flpvsk/read-repeat/design/feedback-tayda-v3-white-fix.pdf

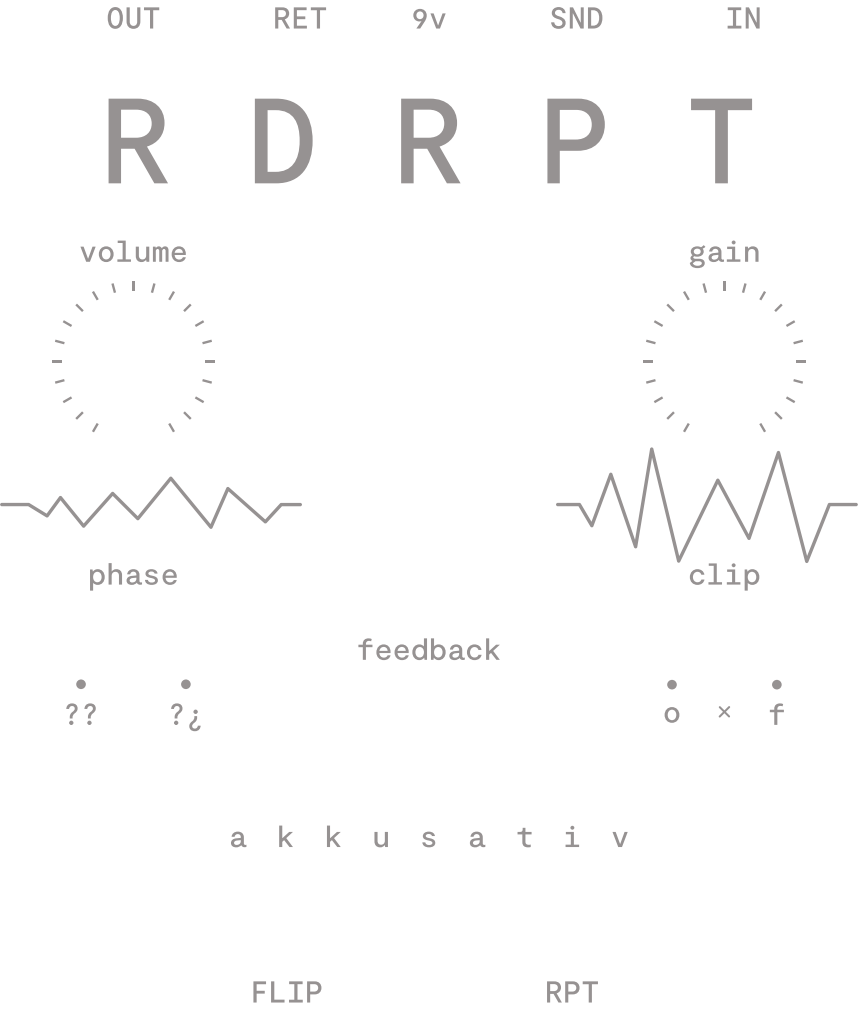
[picture p1: page 1]
