flpvsk/read-repeat/design/feedback-tayda.pdf

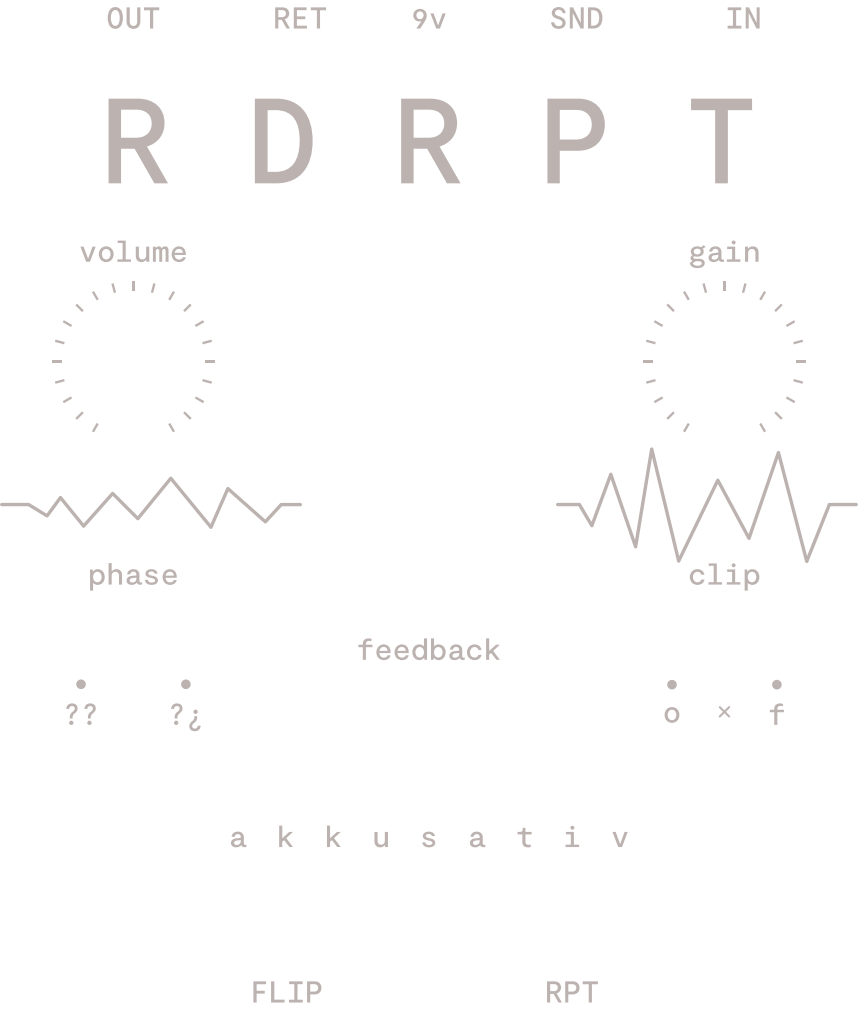
[picture p2: page 1]
