flpvsk/read-repeat/exports/RDRPT-main.pdf

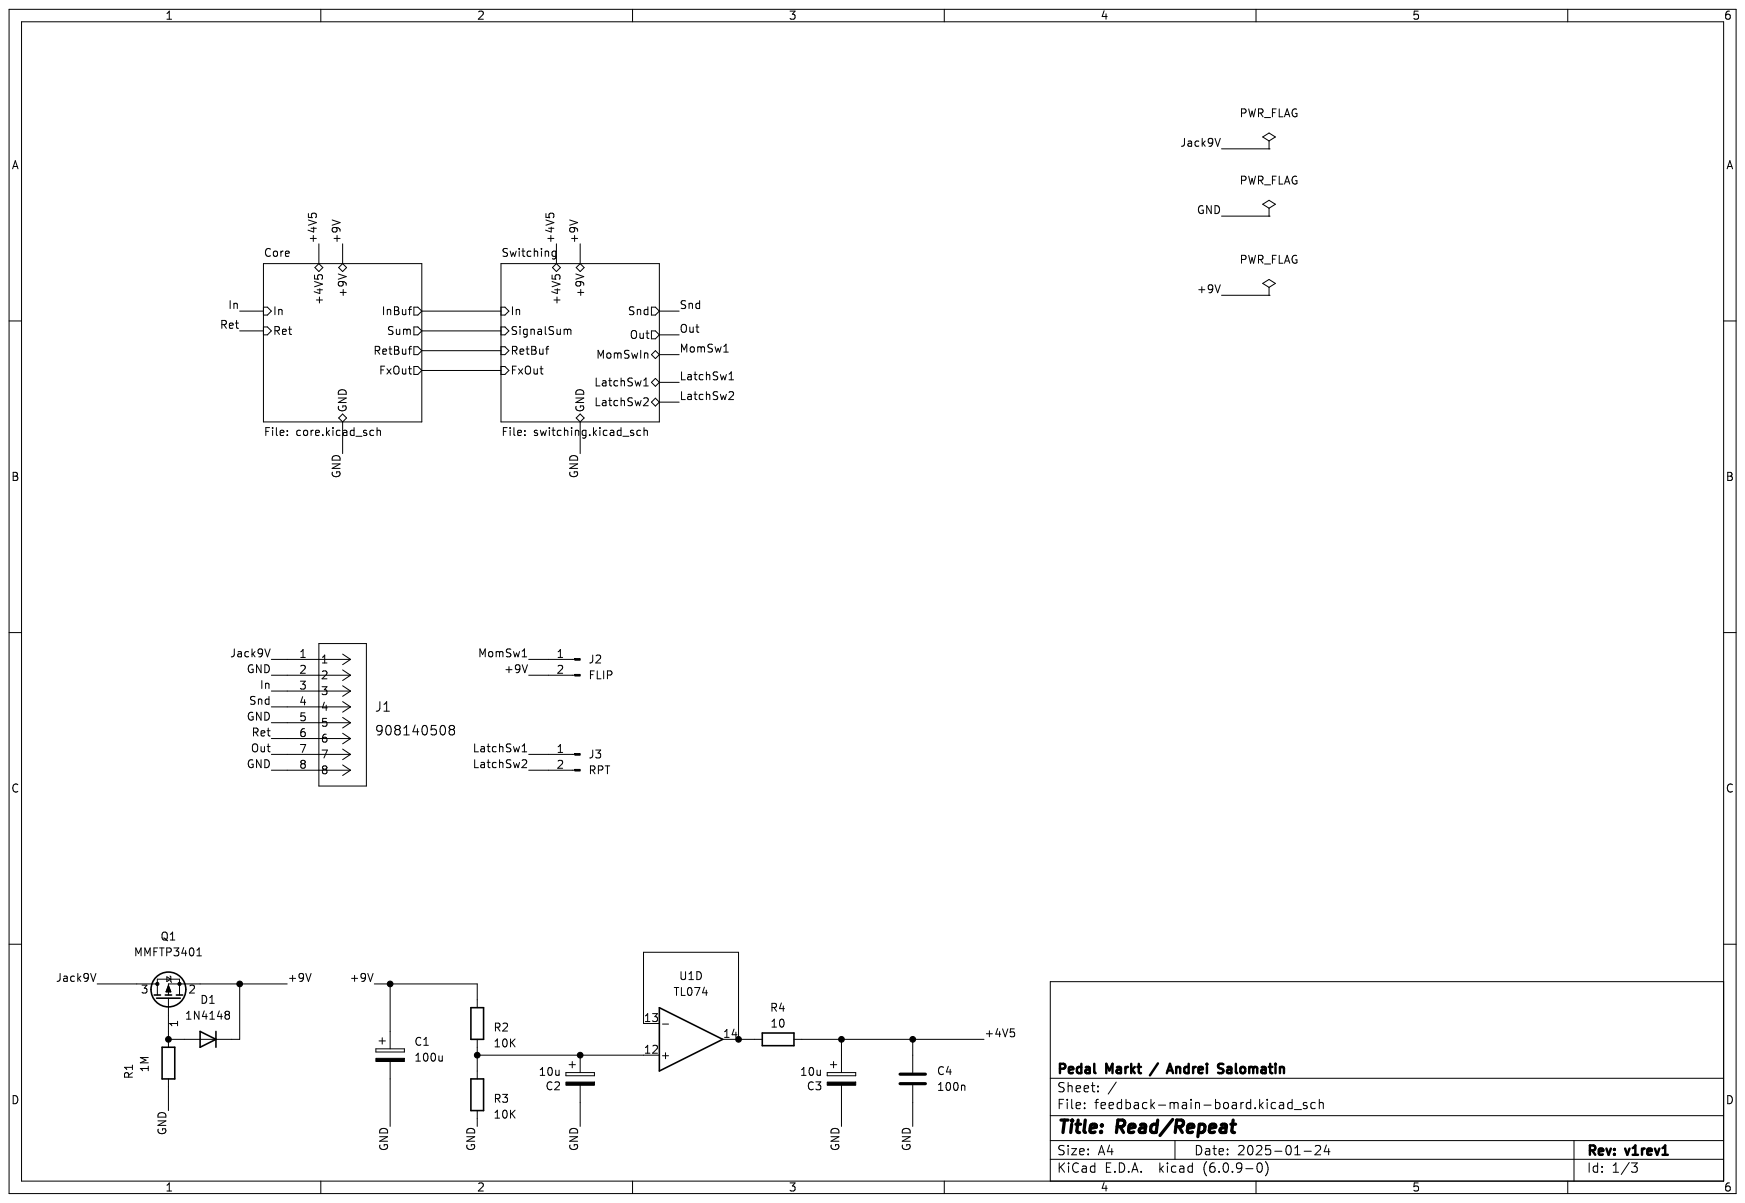
[picture p3: page 1]

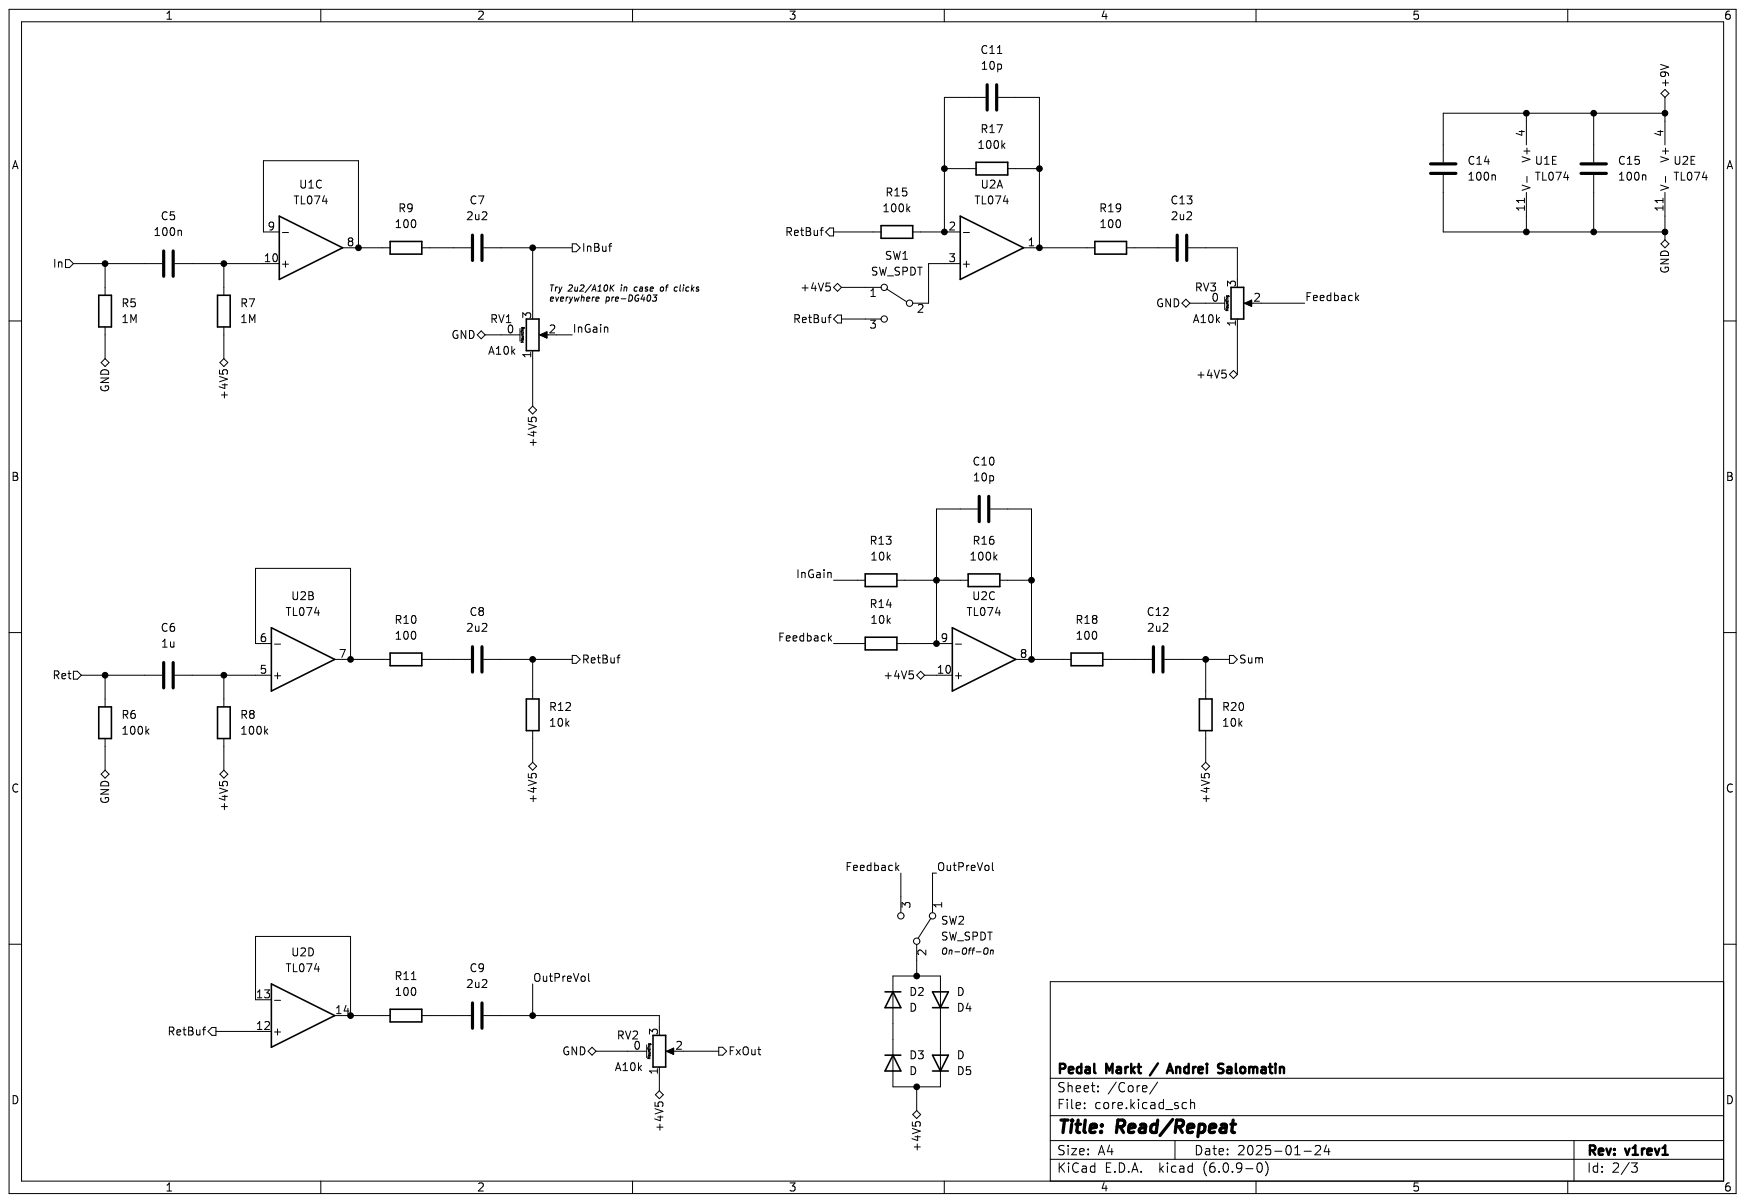
[picture p4: page 2]

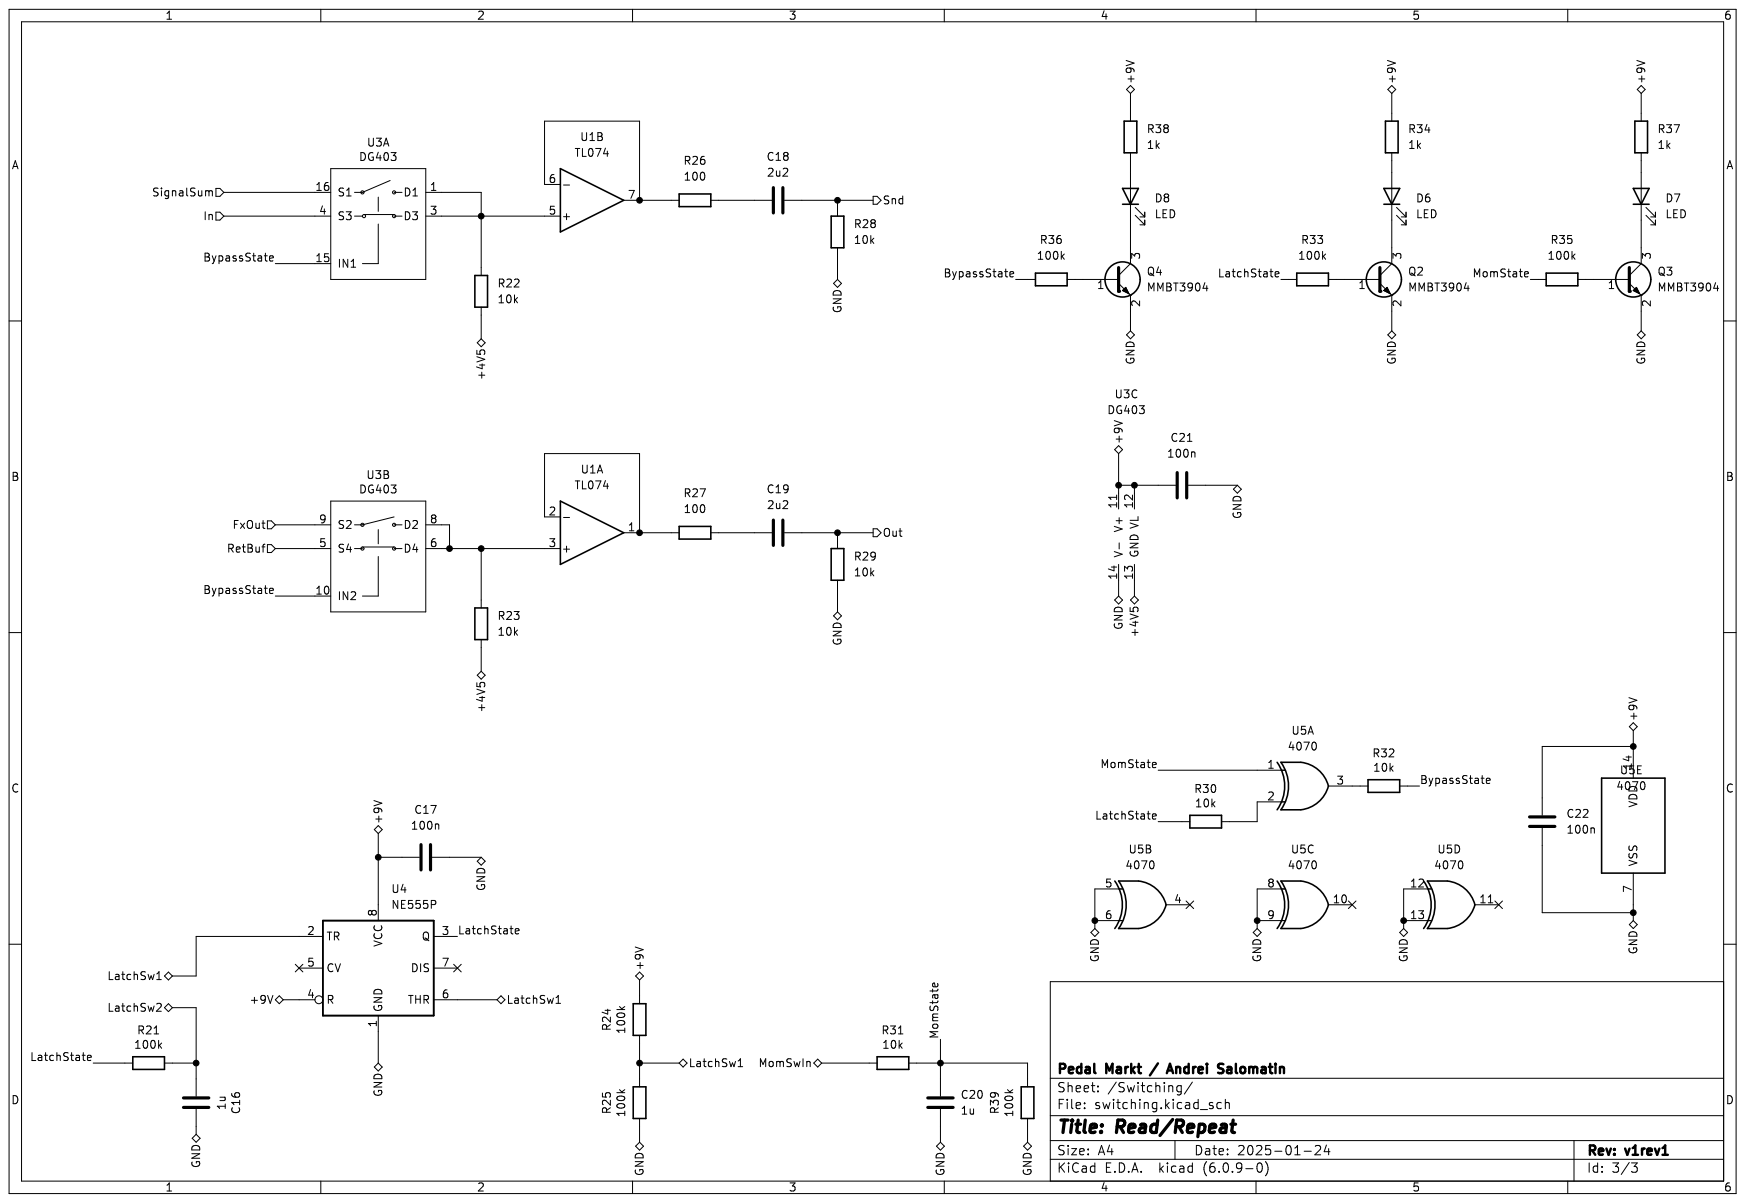
[picture p5: page 3]
