flpvsk/read-repeat/design/feedback-tayda-v2-white-fix.pdf

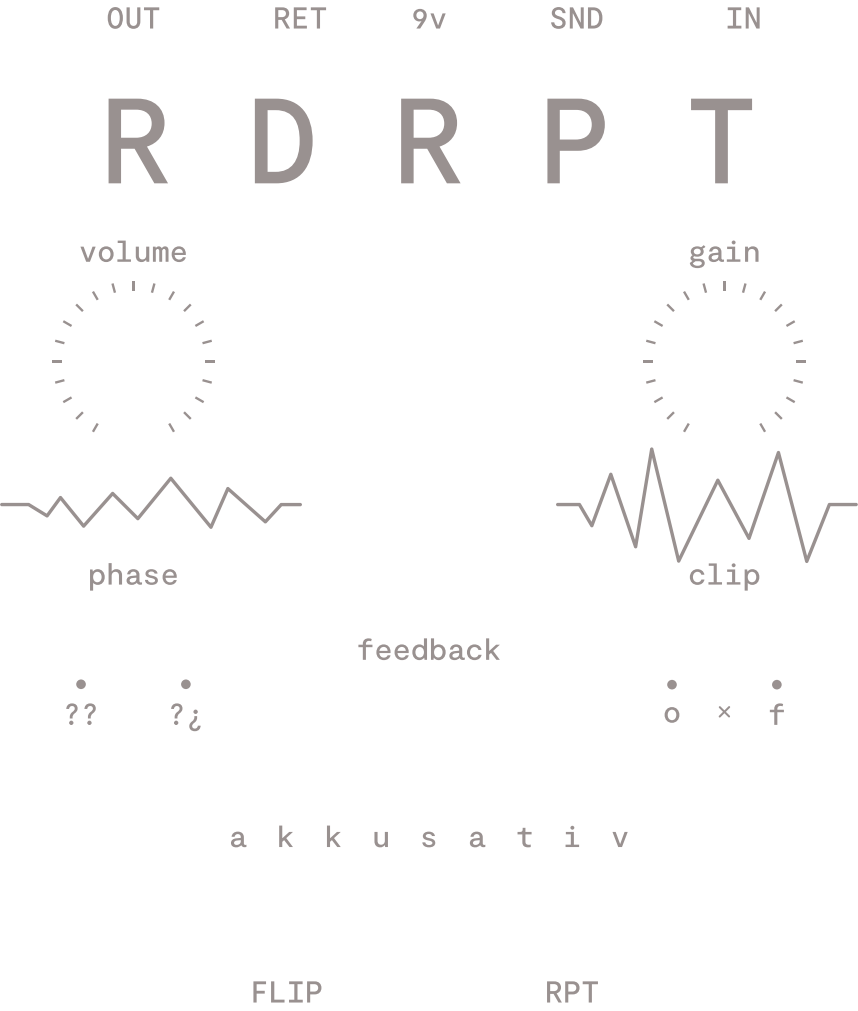
[picture p6: page 1]
