flpvsk/read-repeat/feedback-main-board/feedback-main-board.kicad_pcb

## KiCad design feedback-main-board/feedback-main-board.kicad_pcb (2025-05-19)

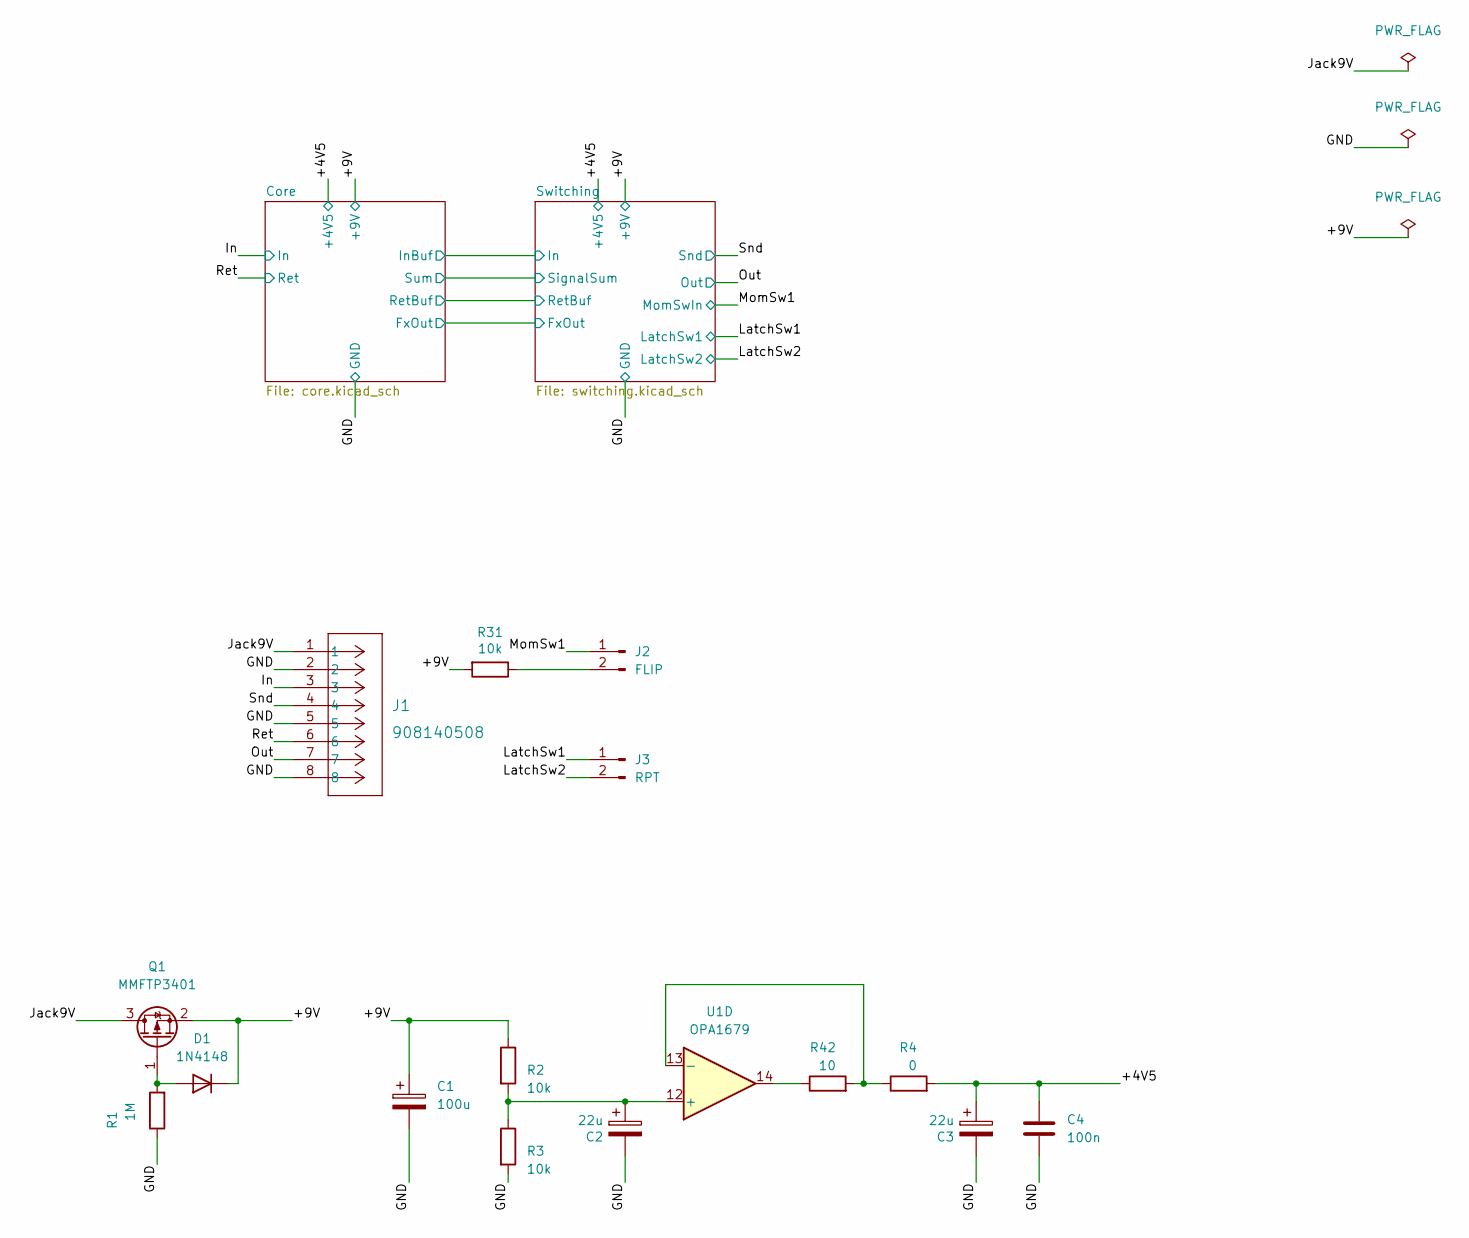
[picture p7: schematic feedback-main-board.kicad_sch, Read/Repeat]

Parts:
C1: 100u; CP_Elec_6.3x5.4; LCSC C2836437
C2, C3: 22u; CP_Elec_5x5.4; LCSC C23289
C4: 100n; C_0603_1608Metric_Pad1.08x0.95mm_HandSolder; Mouser 581-06035C105MAT2A
D1: 1N4148; D_SOD-323_HandSoldering; LCSC C6423741
J1: 908140508; CONN_SDA-90814_08_MOL; LCSC DNP
J2: FLIP; JST_XH_B2B-XH-A_1x02_P2.50mm_Vertical; LCSC DNP
J3: RPT; JST_XH_B2B-XH-A_1x02_P2.50mm_Vertical; LCSC DNP
Q1: MMFTP3401; SOT-23; LCSC C596234
R1: 1M; R_0603_1608Metric_Pad0.98x0.95mm_HandSolder; LCSC C22935
R2, R3, R31: 10k; R_0603_1608Metric_Pad0.98x0.95mm_HandSolder; LCSC C25804
R4: 0; R_0603_1608Metric_Pad0.98x0.95mm_HandSolder; LCSC C21189
R42: 10; R_0603_1608Metric_Pad0.98x0.95mm_HandSolder; LCSC C22859
U1: OPA1679; SOIC-14_3.9x8.7mm_P1.27mm; LCSC C2878631

Connections:
/+4V5: C3.1, C4.2, R4.2; also elsewhere on the board
/+9V: C1.1, D1.1 (K), Q1.2 (S), R2.1, R31.2; also elsewhere on the board
/GND: C1.2, C2.2, C3.2, C4.1, J1.2, J1.5, J1.8, R1.1, R3.2; also elsewhere on the board
/In: J1.3; also elsewhere on the board
/Jack9V: J1.1, Q1.3 (D)
/LatchSw1: J3.1; also elsewhere on the board
/LatchSw2: J3.2; also elsewhere on the board
/MomSw1: J2.1; also elsewhere on the board
/Out: J1.7; also elsewhere on the board
/Ret: J1.6; also elsewhere on the board
/Snd: J1.4; also elsewhere on the board
unnamed: C2.1, R2.2, R3.1, U1.12 (+)
unnamed: D1.2 (A), Q1.1 (G), R1.2
unnamed: J2.2, R31.1
unnamed: R4.1, R42.2, U1.13 (-)
unnamed: R42.1, U1.14

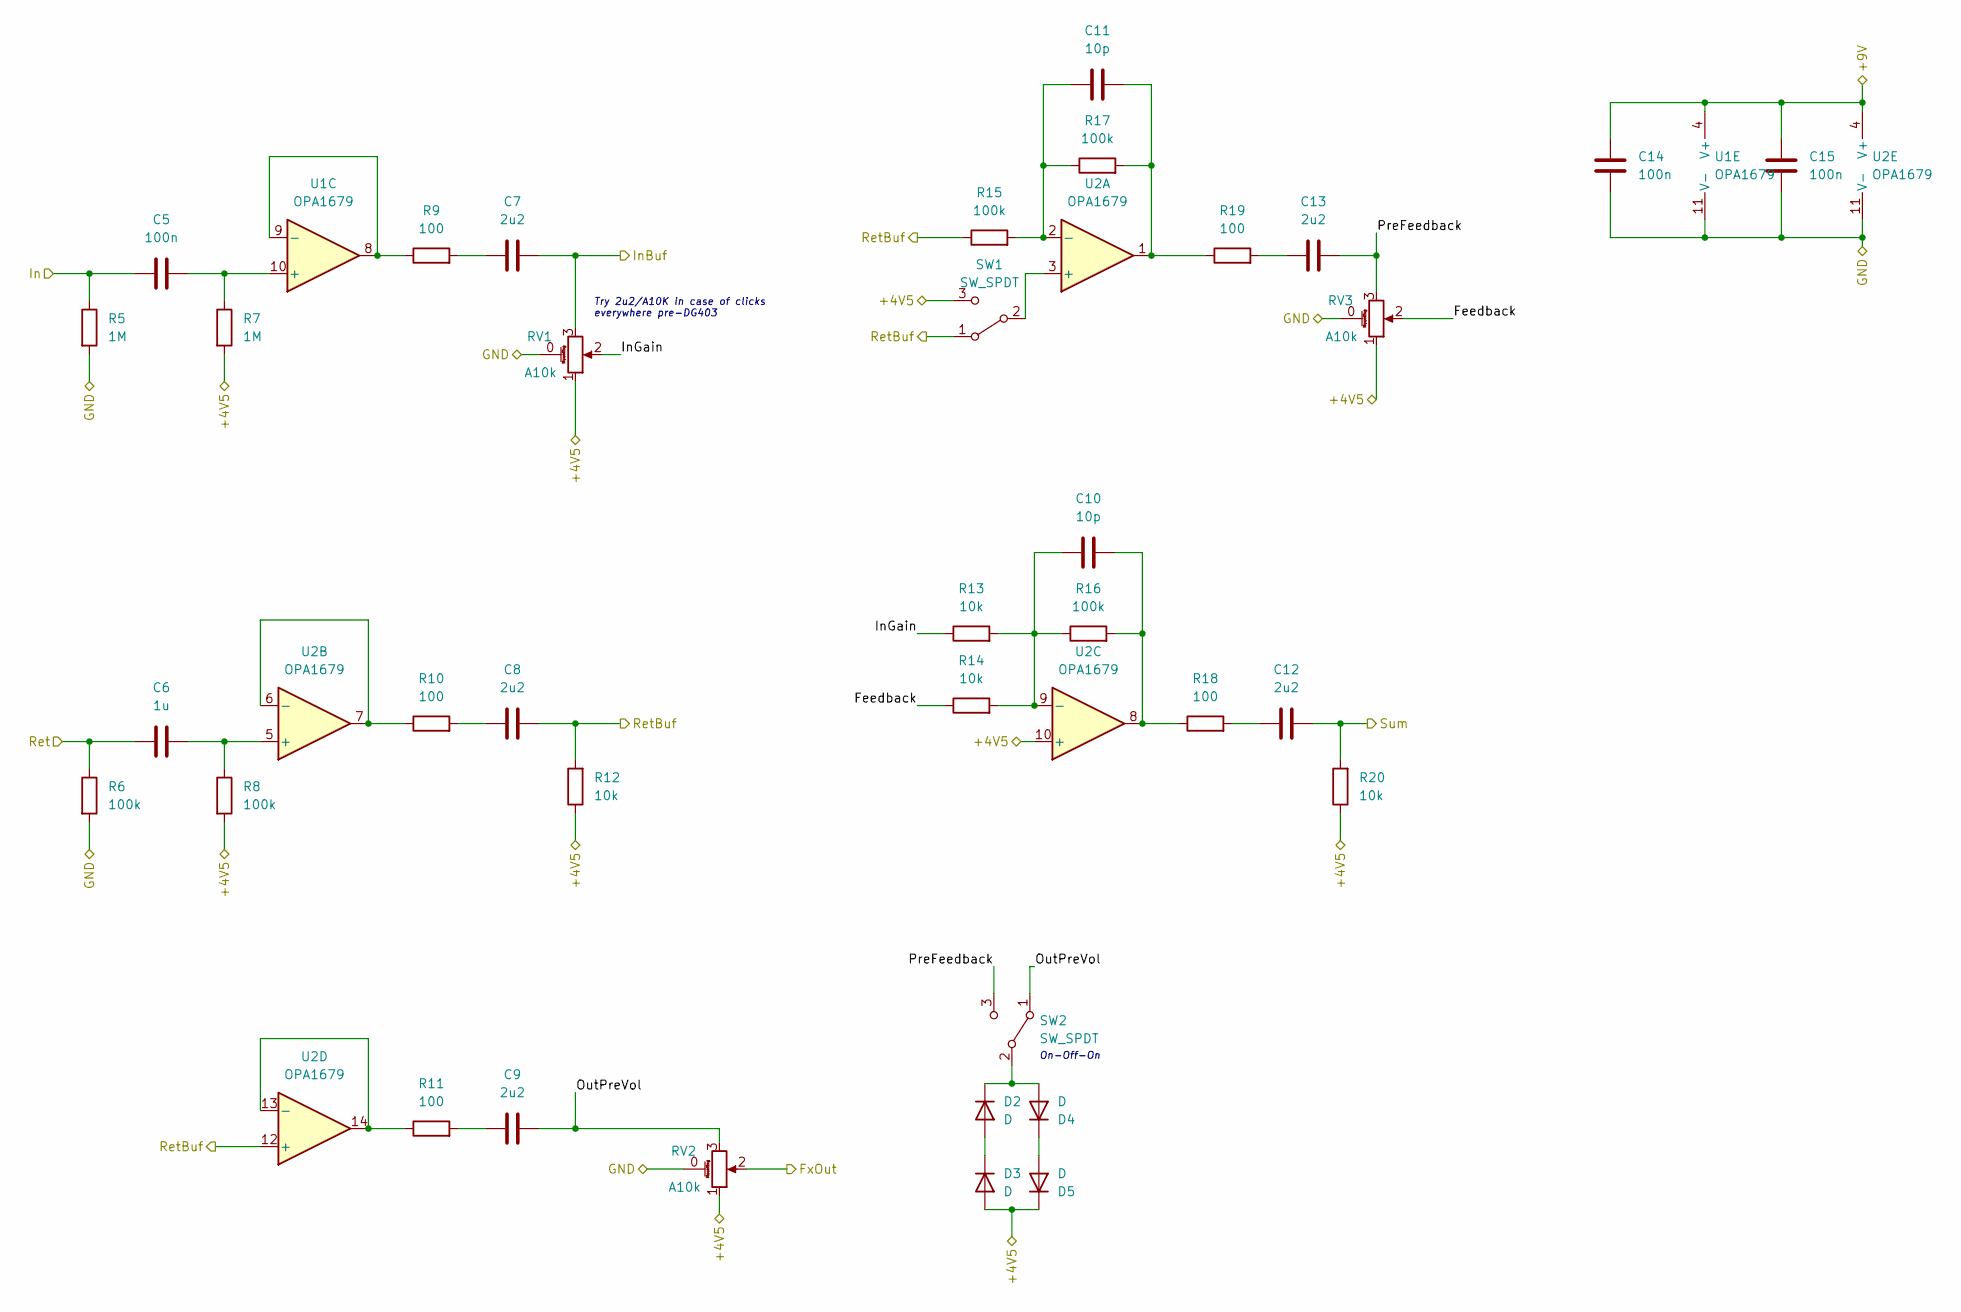
[picture p8: schematic core.kicad_sch, Read/Repeat]

Parts:
C5: 100n; C_Rect_L7.0mm_W2.5mm_P5.00mm; LCSC DNP
C6: 1u; C_Rect_L7.0mm_W4.5mm_P5.00mm; Mouser 505-MKS2-1/63/10A
C7, C8, C9, C12, C13: 2u2; C_Rect_L7.2mm_W7.2mm_P5.00mm_FKS2_FKP2_MKS2_MKP2; Mouser 505-MKS22.2/63/5
C10, C11: 10p; C_0603_1608Metric_Pad1.08x0.95mm_HandSolder; LCSC C1634
C14, C15: 100n; C_0603_1608Metric_Pad1.08x0.95mm_HandSolder; Mouser 581-06035C105MAT2A
D2, D3, D4, D5: D; D_A-405_P7.62mm_Horizontal; LCSC DNP
R5, R7: 1M; R_0603_1608Metric_Pad0.98x0.95mm_HandSolder; LCSC C22935
R6, R8, R15, R16, R17: 100k; R_0603_1608Metric_Pad0.98x0.95mm_HandSolder; LCSC C25803
R9, R10, R11, R18, R19: 100; R_0603_1608Metric_Pad0.98x0.95mm_HandSolder; LCSC C22775
R12, R13, R14, R20: 10k; R_0603_1608Metric_Pad0.98x0.95mm_HandSolder; LCSC C25804
RV1, RV2, RV3: A10k; V3_TRIM_R0904NB10KL-Keepout; LCSC DNP
SW1, SW2: SW_SPDT; SPDT.LUGS.PM; LCSC DNP
U1, U2: OPA1679; SOIC-14_3.9x8.7mm_P1.27mm; LCSC C2878631

Connections:
/+4V5: D3.2 (A), D5.1 (K), R7.2, R8.2, R12.1, R20.1, RV1.1, RV2.1, RV3.1, SW1.3 (C), U2.10 (+); also elsewhere on the board
/+9V: C14.2, C15.2, U1.4 (V+), U2.4 (V+); also elsewhere on the board
/Core/Feedback: R14.1, RV3.2
/Core/FxOut: RV2.2; also elsewhere on the board
/Core/InBuf: C7.2, RV1.3; also elsewhere on the board
/Core/InGain: R13.1, RV1.2
/Core/OutPreVol: C9.2, RV2.3, SW2.1 (A)
/Core/PreFeedback: C13.2, RV3.3, SW2.3 (C)
/Core/RetBuf: C8.2, R12.2, R15.1, SW1.1 (A), U2.12 (+); also elsewhere on the board
/Core/Sum: C12.2, R20.2; also elsewhere on the board
/GND: C14.1, C15.1, R5.2, R6.2, RV1.0 (ShieldPin), RV2.0 (ShieldPin), RV3.0 (ShieldPin), U1.11 (V-), U2.11 (V-); also elsewhere on the board
/In: C5.1, R5.1; also elsewhere on the board
/Ret: C6.1, R6.1; also elsewhere on the board
unnamed: C5.2, R7.1, U1.10 (+)
unnamed: C6.2, R8.1, U2.5 (+)
unnamed: C7.1, R9.2
unnamed: C8.1, R10.2
unnamed: C9.1, R11.2
unnamed: C10.1, R13.2, R14.2, R16.1, U2.9 (-)
unnamed: C10.2, R16.2, R18.1, U2.8
unnamed: C11.1, R15.2, R17.1, U2.2 (-)
unnamed: C11.2, R17.2, R19.1, U2.1
unnamed: C12.1, R18.2
unnamed: C13.1, R19.2
unnamed: D2.1 (K), D4.2 (A), SW2.2 (B)
unnamed: D2.2 (A), D3.1 (K)
unnamed: D4.1 (K), D5.2 (A)
unnamed: R9.1, U1.8, U1.9 (-)
unnamed: R10.1, U2.6 (-), U2.7
unnamed: R11.1, U2.13 (-), U2.14
unnamed: SW1.2 (B), U2.3 (+)

Notes on the sheet:
On-Off-On
Try 2u2/A10K in case of clicks everywhere pre-DG403

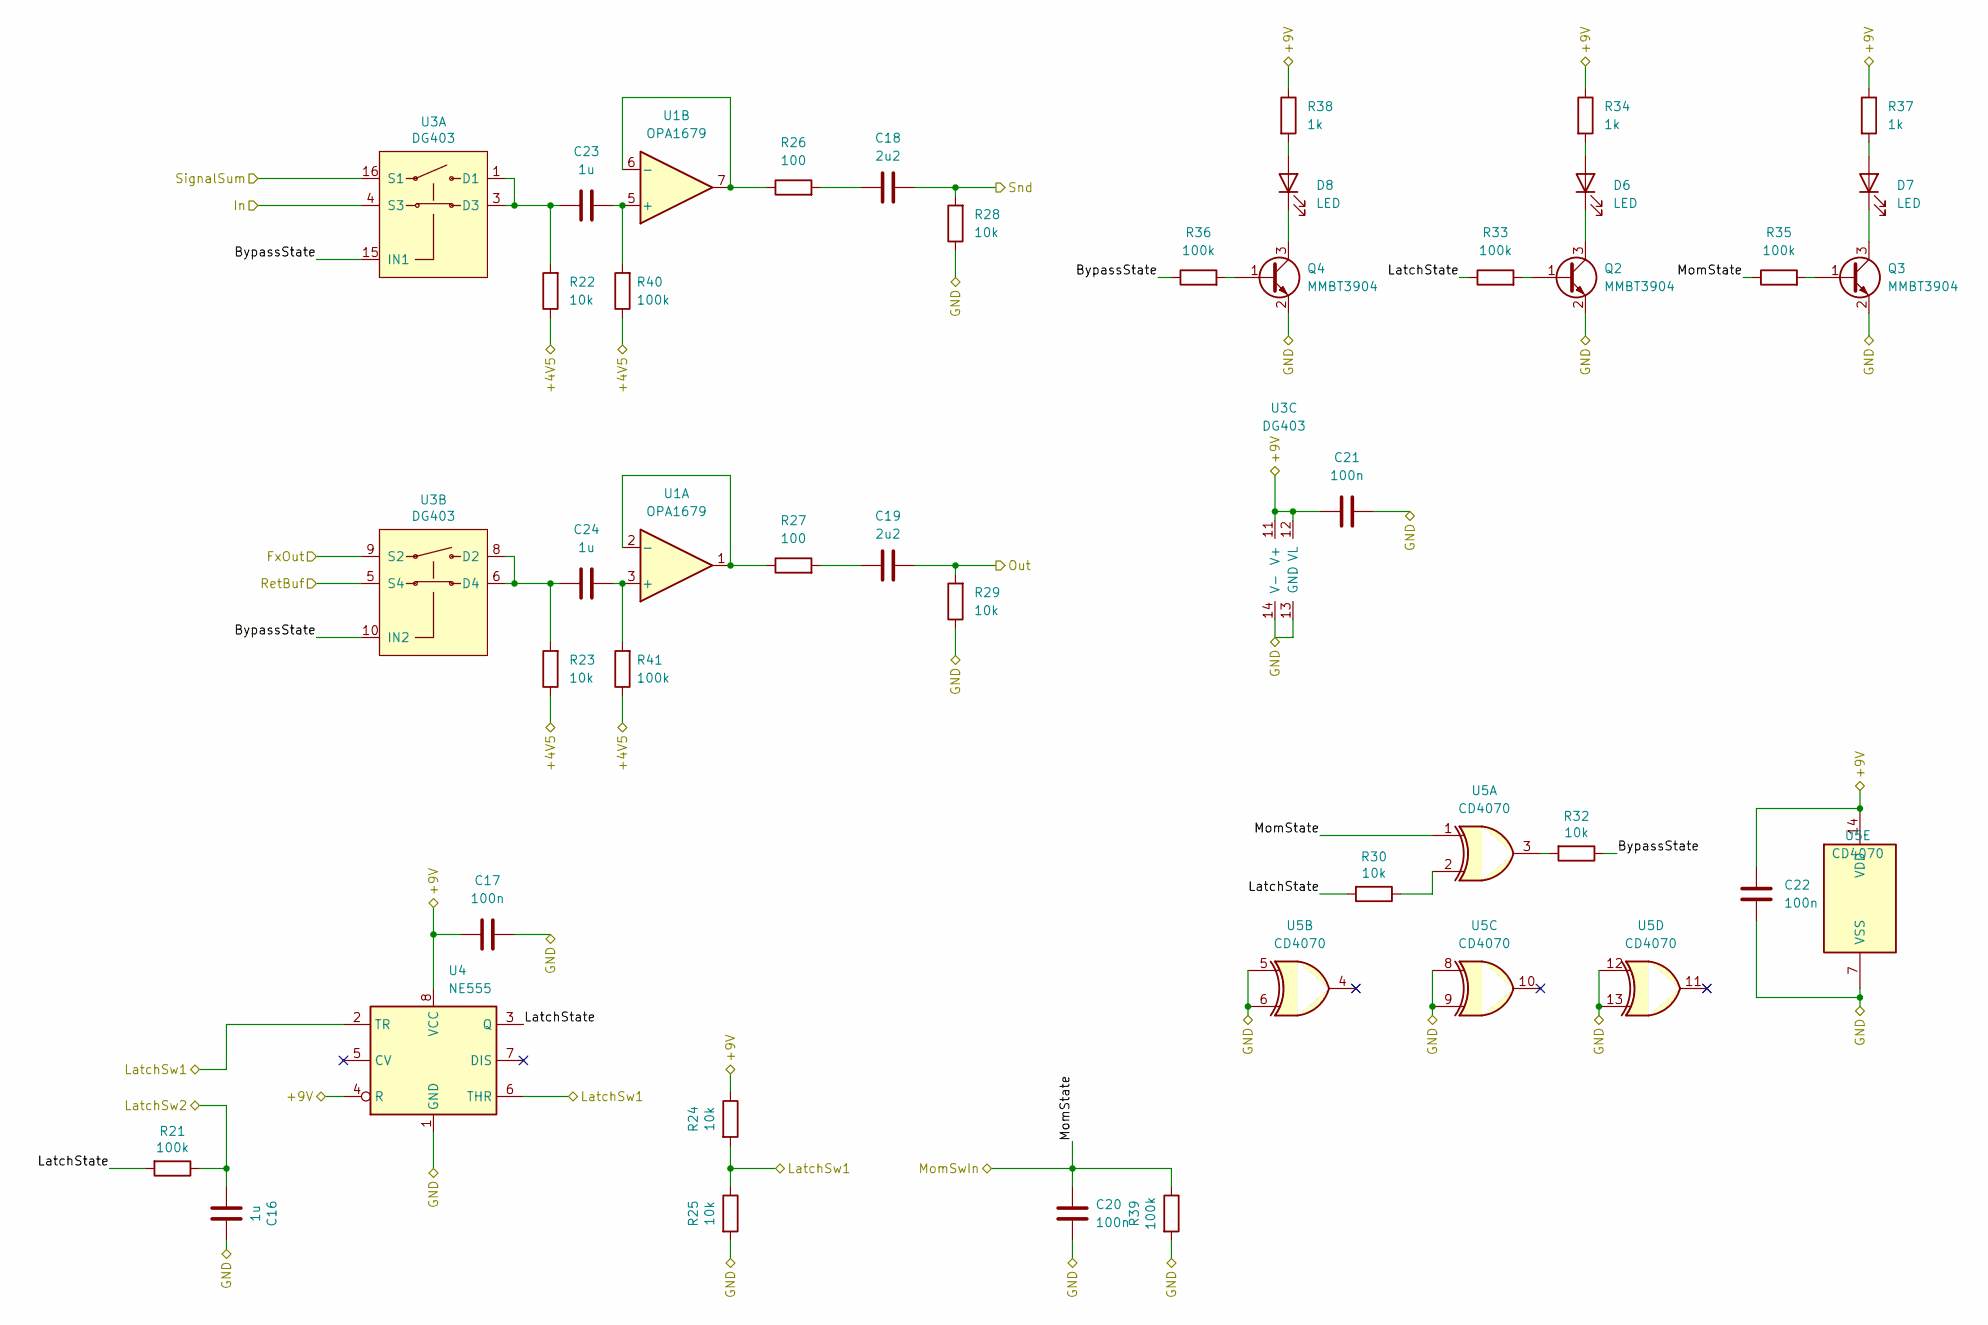
[picture p9: schematic switching.kicad_sch, Read/Repeat]

Parts:
C16: 1u; C_0603_1608Metric_Pad1.08x0.95mm_HandSolder; Mouser 581-06035C105MAT2A
C17, C20, C21, C22: 100n; C_0603_1608Metric_Pad1.08x0.95mm_HandSolder; Mouser 581-06035C105MAT2A
C18, C19: 2u2; C_Rect_L7.2mm_W7.2mm_P5.00mm_FKS2_FKP2_MKS2_MKP2; Mouser 505-MKS22.2/63/5
C23, C24: 1u; C_Rect_L7.0mm_W2.5mm_P5.00mm; LCSC DNP
D6, D7, D8: LED; LED_D5.0mm; LCSC DNP
Q2, Q3, Q4: MMBT3904; SOT-23; LCSC C20526
R21, R33, R35, R36, R39, R40, R41: 100k; R_0603_1608Metric_Pad0.98x0.95mm_HandSolder; LCSC C25803
R22, R23, R24, R25, R28, R29, R30, R32: 10k; R_0603_1608Metric_Pad0.98x0.95mm_HandSolder; LCSC C25804
R26, R27: 100; R_0603_1608Metric_Pad0.98x0.95mm_HandSolder; LCSC C22775
R34, R37, R38: 1k; R_0603_1608Metric_Pad0.98x0.95mm_HandSolder; LCSC C21190
U1: OPA1679; SOIC-14_3.9x8.7mm_P1.27mm; LCSC C2878631
U3: DG403; SOIC-16_3.9x9.9mm_P1.27mm; LCSC C145284
U4: NE555; SOIC-8_3.9x4.9mm_P1.27mm; LCSC C7593
U5: CD4070; SOIC-14_3.9x8.7mm_P1.27mm; Mouser 595-CD4070BM96E4

Connections:
/+4V5: R22.1, R23.1, R40.1, R41.1; also elsewhere on the board
/+9V: C17.1, C21.1, C22.2, R24.1, R34.1, R37.1, R38.1, U3.11 (V+), U3.12 (VL), U4.4 (R), U4.8 (VCC), U5.14 (VDD); also elsewhere on the board
/Core/FxOut: U3.9 (S2); also elsewhere on the board
/Core/InBuf: U3.4 (S3); also elsewhere on the board
/Core/RetBuf: U3.5 (S4); also elsewhere on the board
/Core/Sum: U3.16 (S1); also elsewhere on the board
/GND: C16.1, C17.2, C20.2, C21.2, C22.1, Q2.2 (E), Q3.2 (E), Q4.2 (E), R25.2, R28.1, R29.1, R39.2, U3.13 (GND), U3.14 (V-), U4.1 (GND), U5.5, U5.6, U5.7 (VSS), U5.8, U5.9, U5.12, U5.13; also elsewhere on the board
/LatchSw1: R24.2, R25.1, U4.2 (TR), U4.6 (THR); also elsewhere on the board
/LatchSw2: C16.2, R21.1; also elsewhere on the board
/MomSw1: C20.1, R35.1, R39.1, U5.1; also elsewhere on the board
/Out: C19.2, R29.2; also elsewhere on the board
/Snd: C18.2, R28.2; also elsewhere on the board
/Switching/BypassState: R32.1, R36.1, U3.10 (IN2), U3.15 (IN1)
/Switching/LatchState: R21.2, R30.2, R33.1, U4.3 (Q)
unnamed: C18.1, R26.2
unnamed: C19.1, R27.2
unnamed: C23.1, R22.2, U3.1 (D1), U3.3 (D3)
unnamed: C23.2, R40.2, U1.5 (+)
unnamed: C24.1, R23.2, U3.6 (D4), U3.8 (D2)
unnamed: C24.2, R41.2, U1.3 (+)
unnamed: D6.1 (K), Q2.3 (C)
unnamed: D6.2 (A), R34.2
unnamed: D7.1 (K), Q3.3 (C)
unnamed: D7.2 (A), R37.2
unnamed: D8.1 (K), Q4.3 (C)
unnamed: D8.2 (A), R38.2
unnamed: Q2.1 (B), R33.2
unnamed: Q3.1 (B), R35.2
unnamed: Q4.1 (B), R36.2
unnamed: R26.1, U1.6 (-), U1.7
unnamed: R27.1, U1.1, U1.2 (-)
unnamed: R30.1, U5.2
unnamed: R32.2, U5.3

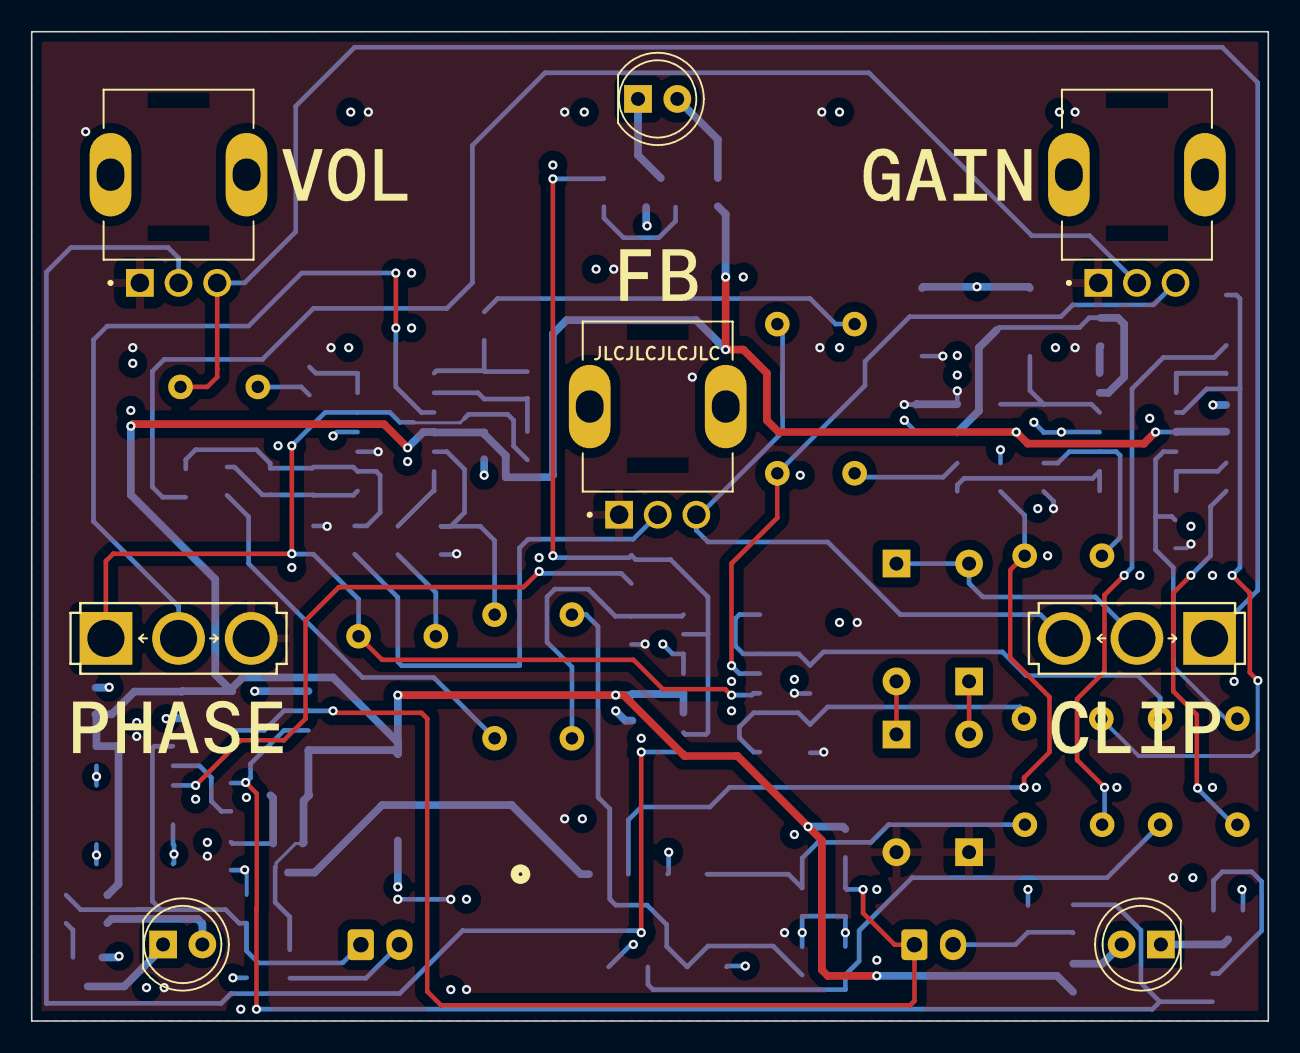
[picture p10: board feedback-main-board.kicad_pcb from above]

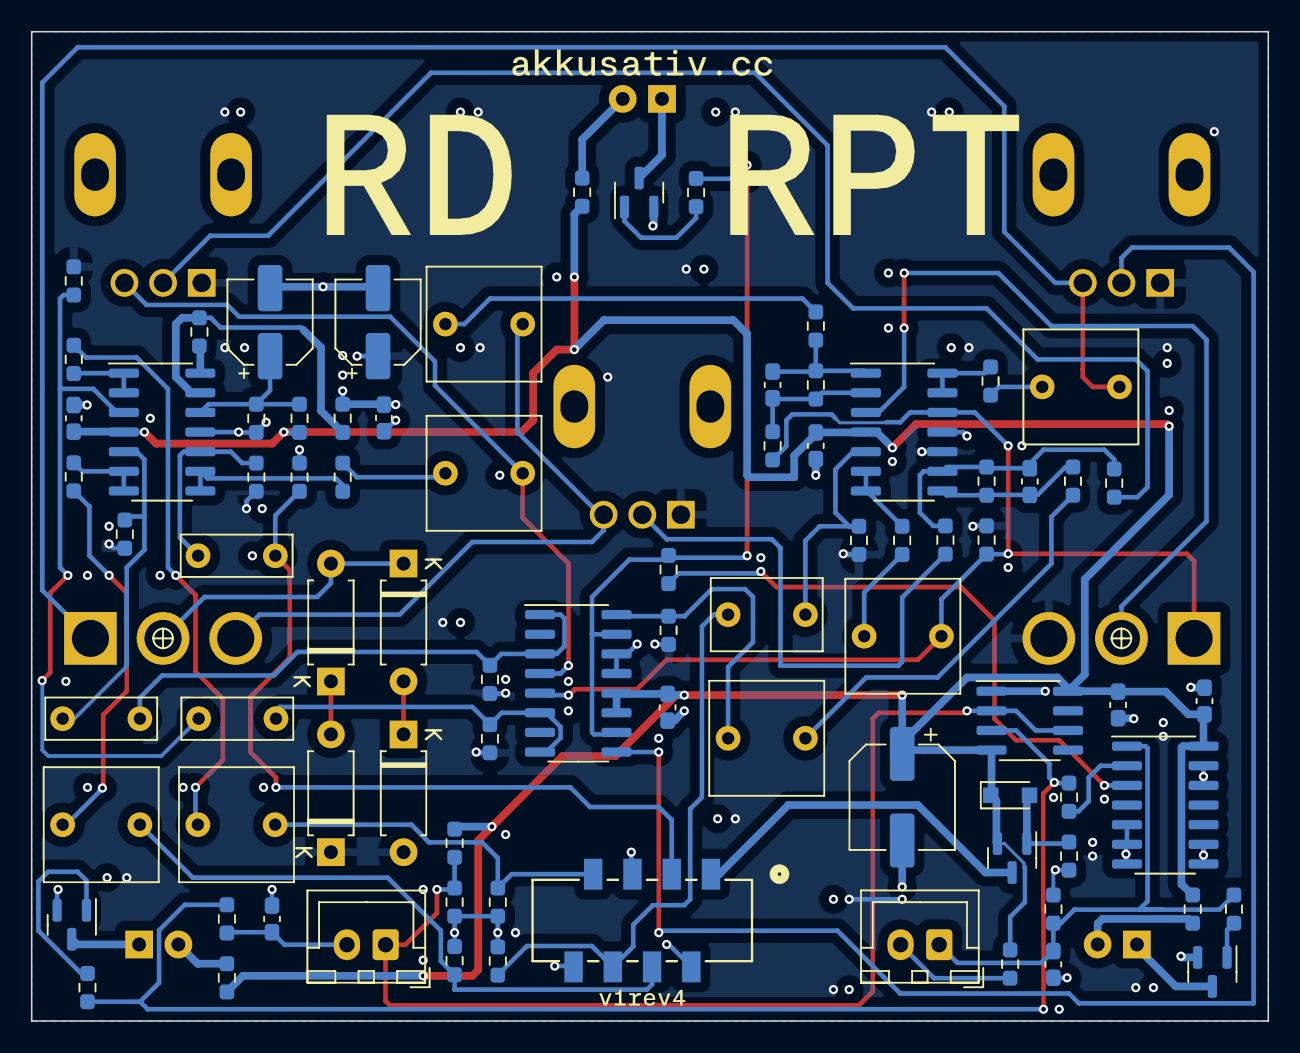
[picture p11: board feedback-main-board.kicad_pcb from below]

Board: 4 copper layers, 80.0 x 64.0 mm, 102 parts (87 on the bottom side), 63 nets.

Other parts of the board:
FLP: FLP; MOMENTARY
RPT: RPT; MOMENTARY
kibuzzard-67A4EAB6: G***; kibuzzard-67A4EAB6
kibuzzard-67A4EAD0: G***; kibuzzard-67A4EAD0
kibuzzard-67A4EB37: G***; kibuzzard-67A4EB37
kibuzzard-67A4EB98: G***; kibuzzard-67A4EB98
kibuzzard-67A4EBC1: G***; kibuzzard-67A4EBC1
kibuzzard-67A4EC3B: G***; kibuzzard-67A4EC3B
kibuzzard-67A4EC49: G***; kibuzzard-67A4EC49
kibuzzard-67A4EDCC: G***; kibuzzard-67A4EDCC
kibuzzard-682B2F26: G***; kibuzzard-682B2F26
