flpvsk/read-repeat/feedback-jack-board/feedback-jack-board.kicad_pcb

## KiCad design feedback-jack-board/feedback-jack-board.kicad_pcb (2025-02-22)

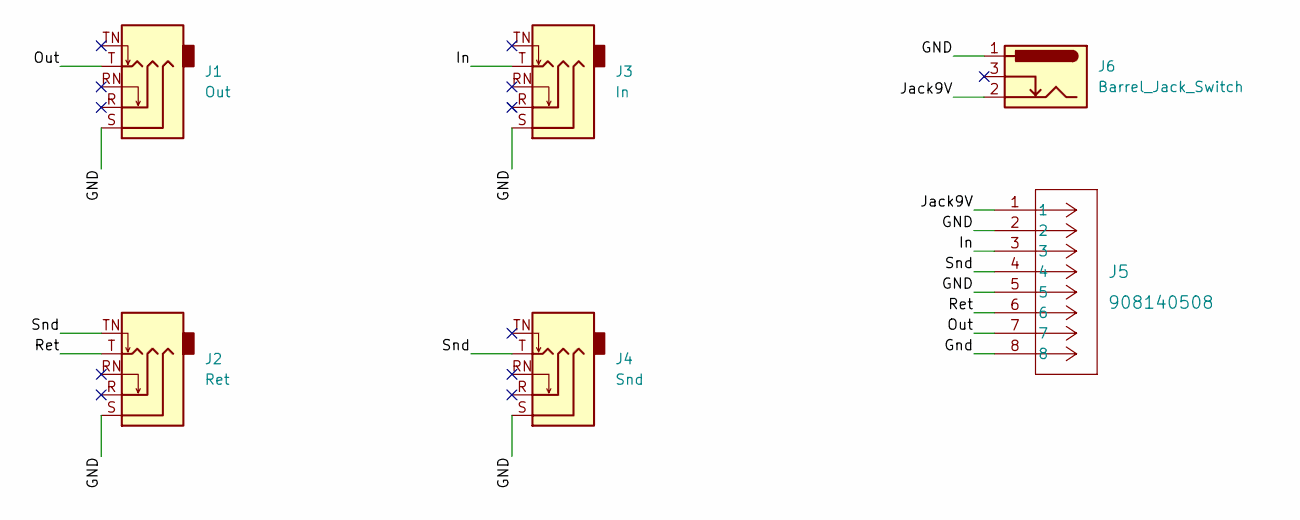
[picture p12: schematic feedback-jack-board.kicad_sch, RDRPT Jacks Board]

Parts:
J1: Out; tayda-A6446-6mm35-jack-pcb-compact
J2: Ret; tayda-A6446-6mm35-jack-pcb-compact
J3: In; tayda-A6446-6mm35-jack-pcb-compact
J4: Snd; tayda-A6446-6mm35-jack-pcb-compact
J5: 908140508; CONN_SDA-90814_08_MOL
J6: Barrel_Jack_Switch; BarrelJack_GCT_DCJ200-10-A_Horizontal

Connections:
/GND: J1.S, J2.S, J3.S, J4.S, J5.2, J5.5, J6.1
/Gnd: J5.8
/In: J3.T, J5.3
/Jack9V: J5.1, J6.2
/Out: J1.T, J5.7
/Ret: J2.T, J5.6
/Snd: J2.TN, J4.T, J5.4

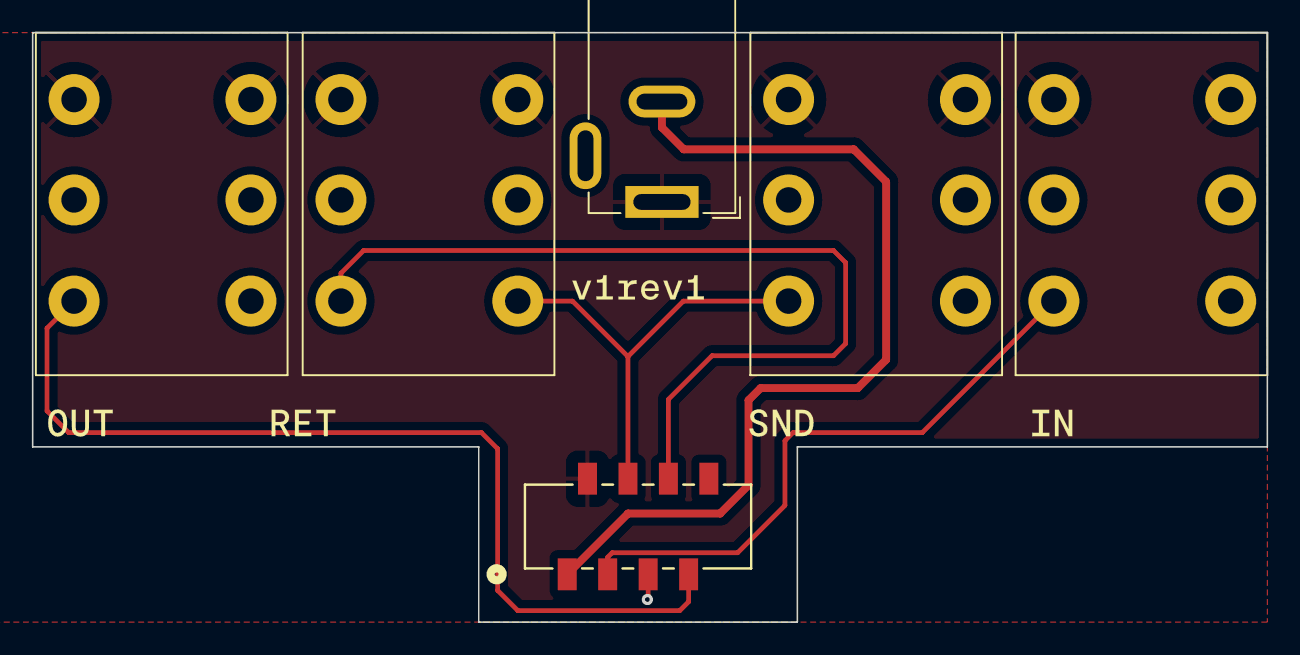
[picture p13: board feedback-jack-board.kicad_pcb from above]

Board: 2 copper layers, 77.5 x 37.0 mm, 12 parts (1 on the bottom side), 6 nets.

Other parts of the board:
kibuzzard-67A4F0EE: G***; kibuzzard-67A4F0EE
kibuzzard-67A4F1E7: G***; kibuzzard-67A4F1E7
kibuzzard-67A4F12B: G***; kibuzzard-67A4F12B
kibuzzard-67A4F13A: G***; kibuzzard-67A4F13A
kibuzzard-67A4F113: G***; kibuzzard-67A4F113
kibuzzard-67A4F143: G***; kibuzzard-67A4F143
