flpvsk/read-repeat/(commit log)

2025-01-24 Schem draft
    [core.kicad_sch, feedback-main-board.kicad_pcb, feedback-main-board.kicad_sch, switching.kicad_sch]
2025-01-27 Jack board
    [feedback-jack-board.kicad_pcb, feedback-jack-board.kicad_sch]
2025-01-29 Switching fixes from breadboarding pre-CD4070
    [feedback-main-board.kicad_sch, switching.kicad_sch]
2025-02-05 Board started
    [core.kicad_sch, feedback-main-board.kicad_pcb, feedback-main-board.kicad_sch, switching.kicad_sch]
2025-02-06 Component placement
    [core.kicad_sch, feedback-main-board.kicad_pcb, feedback-main-board.kicad_sch, switching.kicad_sch]
2025-02-06 Routing v1 done
    [core.kicad_sch, feedback-main-board.kicad_pcb, feedback-main-board.kicad_sch]
2025-02-06 Rotate molex connector properly
    [feedback-jack-board.kicad_pcb, feedback-main-board.kicad_pcb]
2025-02-06 Main PCB done
    [feedback-main-board.kicad_pcb]
2025-02-06 Jacks board layout
    [feedback-jack-board.kicad_pcb, feedback-jack-board.kicad_sch]
2025-02-06 Main v1rev1 ordered at Aisler
    [feedback-main-board.kicad_pcb]
2025-02-06 Jacks board ordered at aisler
    [feedback-jack-board.kicad_pcb]
2025-02-06 Mouser parts ordered
    [core.kicad_sch, feedback-main-board.kicad_sch, switching.kicad_sch]
2025-02-22 rev2 wip start
    [feedback-jack-board.kicad_pcb, feedback-main-board.kicad_sch]
2025-02-23 Wip rev2
    [core.kicad_sch, feedback-main-board.kicad_pcb, feedback-main-board.kicad_sch, switching.kicad_sch]
2025-03-09 Move clipping to pre-feedback
    [core.kicad_sch]
2025-03-14 Changes pre-rev3
    [core.kicad_sch, feedback-main-board.kicad_pcb, feedback-main-board.kicad_sch, switching.kicad_sch]
2025-03-18 JLCPCB rev3 ordered
    [BOM-feedback-main-board.csv, core.kicad_sch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]
2025-03-29 Virtual BOM generated
2025-05-19 Main rev4 ordered
    [BOM-feedback-main-board.csv, core.kicad_sch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]
